jfrNebus/Safe_box/readme_español.md

# Introducción

Este proyecto nace cuando, por necesidades laborales, se necesitó una caja fuerte donde poder almacenar una serie de bienes de valor. En un momento determinado, un departamento de mi empresa retiró, por sustitución, un modelo específico de caja fuerte de un cliente. Este modelo específico tiene asociado un retardo a la apertura de la puerta; es decir, aunque dispongas de la llave y la contraseña, la activación del perno electromagnético que libera la cerradura no se producirá hasta pasado un determinado tiempo. Esto garantiza que, en caso de que el intruso intente coaccionar al responsable de la caja, esta no se abra hasta que el tiempo de retardo haya finalizado, lo que lo obliga a permanecer más tiempo en la instalación, arriesgándose a ser capturado. Esta caja fuerte fue depositada en el apartado de desechos para reciclar, era un modelo antiguo no óptimo para dicho cliente. Adicionalmente, se desconocía la contraseña.

Estas cajas están pensadas para ser fijadas a una superficie debido a que el perno actúa por gravedad. Es decir, si la bobina del perno no tiene alimentación, el perno permanece en su posición por la acción de la gravedad, bloqueando la acción de la llave sobre la cerradura. Cuando se alimenta el circuito y se introduce la contraseña de forma correcta, el circuito alimenta la bobina del perno, atrayéndolo, liberando la acción de la llave.

<br>
<br>

## Funcionamiento 🧰

<br>

<p align="center">
  
</p>

En la imagen anterior tenemos el interior del sistema de control. Lo primero que se observa es la placa de control implementada por mi; el perno electromagnético, la pieza de color amarillento en la que está escrito “12 Ohms”; y por último, el cierre y la cara interior de la cerradura. El cierre se mueve de izquierda a derecha en función de la acción de la llave. Las flechas dibujadas muestran el comportamiento del cierre y del perno en función de la alimentación que reciba la bobina. Si la bobina, la pieza rectangular amarillenta recibe alimentación, el perno, la pieza cilíndrica ubicada justo debajo de la bobina, se verá atraída hacia la bobina, permitiendo el libre movimiento del cierre. Si la bobina no recibe alimentación, el perno cae por su propio peso, bloqueando el movimiento del cierre, impidiendo la acción de la llave.

Lo primero que hice fue descubrir la forma de abrir la caja. Por suerte la llave estaba puesta en la cerradura, el problema era ver cómo sortear el perno electromagnético. Al no estar fijada a ninguna superficie, en cuanto le di la vuelta a la caja, el perno cayó por gravedad al interior de la bobina, liberando la cerradura. Una vez abierta la caja, la desmonté por completo y analicé cada parte.

<br>

### **Placa original**: 

<br>

<p align="center">
  
</p>

<br>

Esta es la placa original de la caja. Se observan un par de elementos de interés:

- Microcontrolador TSC80C31, con 32 entradas y salidas, y 128 bytes de RAM. 
- Memoria EPROM M27C64A. Esta memoria es ideal para programas largos. Como curiosidad, cabe destacar la ventana que se observa en el medio de la memoria, la cual sirve para borrar su contenido apuntando a la misma con un haz de luz ultravioleta. A continuación, se muestran unas imágenes del interior de dicha ventana al microscopio.

<br>

<p align="center">
  
  
  
 
</p>

<br>

### **Perno electromagnético**:

<br>

<p align="center">
  
</p>

<br>

Ya hemos hablado de esta parte anteriormente. Es el encargado de bloquear o liberar la acción de la llave. El valor impreso en el cuerpo es el valor de la resistencia de la bobina, en este caso 12 ohmios. Este valor es el que se toma a la hora de hacer cálculos para conocer la intensidad de corriente mínima que ha de proveer la fuente de alimentación para hacer que la bobina atraiga correctamente al perno. Cuando se alimenta la bobina por medio de los cables, se genera un campo magnético que atrae a todos los cuerpos ferromagnéticos, en este caso, el perno. Cuando la alimentación se pierde, se pierde a su vez el campo magnético, ocasionando que el perno caiga por su propio peso bloqueando el cierre.

<br>

### **Teclado**:

<br>

<p align="center">
  
</p>

<br>

A través del teclado se introduce la clave de acceso, que será recogida por la placa para su evaluación. Si la clave es correcta, el perno electromagnético se activa. 

<br>

<p align="center">
 
 
</p>

Resulta facil darse cuenta de que se trata de un teclado matricial en cuanto se observa la placa sin la capa de los números. Este teclado está compuesto por un total de 12 pulsadores de membrana conductiva. Este tipo de pulsadores están formados por dos partes: la parte de los contactos impresos en la placa, las partes ovaladas con una línea en el medio; y la capa de números, una superficie de goma con un material conductor debajo de cada botón. Cuando se presiona dicho botón de silicona, la parte conductora debajo del mismo toca los dos lados del óvalo impreso en la placa, cerrando el circuito.

<br>

<p align="center">
 
</p>

<br>

En un teclado matricial, el conexionado de los botones se realiza mediante filas y columnas; cada lado de cada botón esta conectado a una fila y a una columna. En la imagen anterior tenemos un modelo que he creado para explicar el concepto. El principio de funcionamiento se basa en alimentar uno de los lados de los pulsadores, y leer el valor de voltaje en el otro lado. Es decir, podemos alimentar con un voltaje las columnas, por ejemplo, y realizar la lectura de voltaje presente en las filas.

Supongamos que hemos pulsado el botón 4. Empezamos alimentando con voltaje solo la columna 1, dejando sin voltaje las columnas 2 y 3. La columna 1, (columns 1), se conecta con el lado 1 del botón 1, con el lado 1 del botón 2 y con el lado 1 del botón 3, (SW1, SW2 y SW3). Por lo tanto, estos tres botones pasan tener alimentación en su lado 1. Acto seguido, le indicamos al sistema que lea el valor de voltaje presente en las filas, (rows). Empieza leyendo el valor de la fila 1. En la fila 1 tenemos el lado 2 del botón 1, que no ha sido presionado, por lo tanto el circuito no se cierra y la tensión, el voltaje, enviado por la columna 1 no llega al lado 2 del botón, con lo que la lectura en la fila 1 es 0V. Esto es interpretado por el sistema como que el botón 1 no ha sido presionado. A continuación, seguimos leyendo los pulsadores de la fila 1 y nos encontramos el botón 4, que si que fué presionado. El el lado 1 del botón 4, se conecta con la columna 2, columna que no está siendo alimentada en esta fase del análisis, luego aunque se cierre el circuito al presionar el botón, la lectura en la fila 1 sigue siendo 0. Lo mismo ocurre con el botón 7. Esto quiere decir que por la fila 1 no existe voltaje alguno. En este punto se garantiza que no se ha pulsado el botón 1, porque para que dicho botón se considere pulsado, tendría que existir una lectura positiva de voltaje en la fila 1 mientras la columna 1 esta siendo alimentada.

Habiendo entendido el análisis completo del comportamiento de la fila 1 y de cada uno de los botones asociados a ella, podemos resumir el análisis de las filas 2 y 3. Continuamos leyendo el valor de voltaje en la fila 2. La columna que nos interesa es la 1, dado que el botón 2 no ha sido presionado, ocurre lo mismo que con el botón 1, no existe lectura positiva en la fila 2 cuando la columna 1 está siendo alimentada, lo que garantiza que el botón 2 no ha sido presionado. Seguimos leyendo el valor de la fila 3. El botón 3 no se presionó, no se cierra el circuito, no hay lectura de voltaje positiva en la fila 3 cuando la columna 1 está siendo alimentada, por lo que se garantiza que el botón 3 no ha sido presionado.

En este punto, habiendo recibido lectura negativa en las tres filas, el sistema entiende que el botón presionado es alguno de los asociados a las columnas 2 y 3, por lo que se repite la misma actuación. Se retira la alimentación de la columna 1, se alimenta la columna 2, y se mantiene sin alimentación la columna 3. En este punto, se inicia un nuevo proceso de lectura de filas. Empezamos leyendo el valor de la fila uno, que en este caso es un valor positivo. El valor de la fila 1 es positivo porque el botón presionado es el 4, que está asociado a la fila 1 por su lado 2, y a la columna 2 por su lado número 1. Cuando se presiona el botón 4 mientras existe alimentación en la columna 2, se cierra el circuito con la fila 1, generando un valor de lectura positivo en la fila 1. Esto es interpretado por el sistema, el valor de lectura de voltaje positivo, como que dicho botón, el botón asociado a las fila 1 y columna 2, ha sido presionado. En este momento se detiene el análisis y se realiza la operación pertinente. 

Entender el funcionamiento de un teclado matricial es vital para la optimización de recursos, cuando se trabaja con un teclado. Un teclado con 9 botones supondría, habitualmente, si no se usa un teclado matricial, el uso de 9 entradas en un microcontrolador, además de todo el cableado asociado a los mismos. Como hemos visto en el ejemplo anterior, para un teclado de 9 botones, hemos usado 6 contactos del microcontrolador. De esos 6 contactos, 3 se usan como entradas para recibir la lectura de las filas, y 3 como salidas para establecer el pulso alto de voltaje para cada columna.

<br>

<p align="center">
 
</p>

<br>

Teniendo claro qué es, y cómo funciona un teclado matricial, podemos observar, en la imagen anterior, que el teclado de la caja fuerte también es un teclado matricial. En la imagen se observan dos figuras bastante más complejas que la del primer ejemplo. Ambas figuras representan el conexionado real del teclado. En la figura de la izquierda vemos una serie de pulsadores, colocados en dos filas y orientados de forma vertical, junto a los tres diodos LED de colores. Algunas de los tramos de ciertas pistas de conexión son de color azul, representan las partes de las pistas que están impresas por la cara trasera de la placa; las pistas de color vino, representan las pistas impresas en la cara frontal de la placa. El recorrido de algunas de las pistas varía ligeramente respecto a las pistas impresas en la placa, no obstante es una representación clara. La figura de la derecha mantiene el conexionado real entre pulsadores y pines, pero he organizado todo de forma que resulte más fácil percibir la union de las columnas y las filas, con los pulsadores. Las pistas de color amarillo representan las columnas, y las pistas de color verde representan las filas. El boton * se conecta a dos pines de forma independiente, porque así lo creyó oportuno el desarrollador que diseñó la placa del circuito.
Teniendo claro todo lo explicado anteriormente, solo queda leerse las comentarios escritos en el propio código para entender el funcionamiento completo del sistema. 

<br>

<p align="center">
    
    
</p>

<br>
<br>

## Desarrollo de placa :electron:

<br>

<p align="center"> 
  
  
</p>

El proyecto se encuentra actualmente en la versión dos. Al igual que se han modificado varios bloques de código para corregir ciertas prácticas de programación, y para incorporar nuevos elementos de electrónica, se ha corregido y rediseñado la propia placa. En las anteriores fotos se pueden observar ambas caras de la placa correspondiente a la versión uno.

<br>

En un origen usé un mosfet IRFP150 para el control del perno electromagnético, porque era lo que tenía más a mano en mi taller, no obstante este mosfet esta sobredimensionado para este circuito. Recientemente, a la hora de rediseñar la placa, encontré un transistor TIP31 en el taller, el cual es más acorde a las necesidades del circuito. Donde el mosfet aguanta valores en drain-source de hasta 100V de tensión y 44A de corriente, el tip31 aguanta en colector-emisor de hasta 40V de tensión y 3A de corriente.

En la versión uno del circuito, la gestión de los led se lograba por medio de un tipo de lógica de programación erronea; actualmente esa lógica se ha corregido y se han implementado 3 transistores para el control de los led. El transistor usado es el 2N3904, cuyos valores máximos en colector-emisor son 40V y 200mA, valores de sobra para controlar leds que trabajan en torno a los 2V y 20 miliamperios.

<br>

### **Cálculo de resistencias :zap:** 

<br>

A continuación, se muestran todas las operaciones necesarias para el cálculo de resistencias en base de los transistores de la placa.

<hr>
RBE = Resistencia base-emisor.
<br>
VB = Tensión en base.
<br>
IB = Corriente en base.
<br>
β = Ganancia de intensidad para el transistor, (also known as hFE).
<br>
IC = Corriente en colector.

<br>
<br>

RBE = VB / IB
<br>
β = IC / IB  >> IB = IC / β
<br>
0.7 = Caida de tensión en la únion base-emisor del transistor.

<br>
<br>

•	Sin aplicar el factor de protección sobre Ib:

  RBE = (VB - 0.7) / (IC / β)

<br>
<br>

•	Con factor de protección sobre Ib:

  RBE = (VB - 0.7) / 3 * (IC / β)
  
  Este factor se usa para incrementar la intensidad en base, esto garantiza que el transistor entre en saturación profunda y funcione como un interruptor.

<hr>

<br>

#### - Resistencia base-emisor TIP31

<br>

β mínima según datasheet = 25
<br>
β según polímetro = 25

•	Sin aplicar el factor de protección sobre Ib:
RBE = (5 – 0.7) / (1 / 25) = 107,51

•	Con factor de protección sobre Ib:
RBE = (5 – 0.7) / 3 * (1 / 25) = 35,8

Al final se usa el cálculo con factor de protección para garantizar la saturación del transistor en su uso como interruptor. Se usa un valor de resistencia común de 22Ω.

<br>

#### - Resistencia base-emisor 2N3904 y resistencias de protección para los led.

<br>

**Resistencias de protección para los LEDs**

Se trata de 3 led de 3mm.
<br>
•	Rojo: 20mA, 1.9-2.1V.
<br>
•	Amarillo: 20mA, 2V.
<br>
•	Verde: 20mA, 2.2-2.4V

Calculo de la resistencia en serie para proteger el led:

R = (Vfuente – VLED) / I

•	Rojo y amarillo:
<br>
R = (12 – 1.9) / 0.02 = 505 Ohms
<br>
•	Verde:
<br>
R = (12 – 2.2) / 0.02 = 490 Ohms

Finalmente, se usan resistencias de 560Ω. Esto es debido a que el otro valor estándar inmediato es de 470Ω. Es preferible exceder el valor, antes que quedarse corto y forzar los leds. No obstante, el daño ocasionado por una resistencia de 470Ω sería prácticamente nulo.

<br>

**Resistencias base-emisor**

β según data sheet = 100
<br>
β según multímetro = 151

•	β según data sheet: 
  RBE = (5-0.7) / (3*(0.02/100)) = 4,3 / (3 * 0.0002) = 4,3 / 0.0006  = 7166,66

Se usa un valor de resistencia común de 5,6kΩ.

<br>

### **Desarrollo del PCB :mechanic:**

A continuación se muestra el esquema eléctrico, el diseño de la PCB, y el modelo 3D de la misma.

<br>
<br>

<p align="center"> 
 
</p>

<br>

Haciendo clic en el siguiente [enlace](Docs/Images/V1_schematic.png), podemos acceder al esquema electrónico de la primera versión de la placa. En un origen se escribió el código estableciendo el conexionado entre los pines del teclado y los pines del aruino, siguiendo la correlación numérica, es decir, el pin 1 del conector del teclado con el pin 1 de la placa etc. Esto generaba que, por la ubicación del conector del teclado y la posición del arduino, el cableado entre pines se cruzase. Esto ha sido corregido en código, generando un conexionado mucho más limpio. Adicionalmente, el esquema de la versión 2 incluye el bloque de conexiones de los transistores de control para el manejo de los led.

Para este proyecto tuve que crear un nuevo elemento, el conector hembra de 13 pines. O bien no lo encontré entre las librerías pero existe, o bien no existe. Para su creación tomé como referencia uno de menor número de pines.

<br>

<p align="center"> 
 
 
</p>

<br>

De izquierda a derecha: capa superior, ubicación de los elementos; capa inferior, routeo de los elementos; capa de drill, mapa de perforación de los pad de los elementos.

<br>

<p align="center"> 
 
 &nbsp;
 
 &nbsp;
 
</p>

<br>

De izquierda a derecha: capa superior, capa mixta, capa inferior.

<p align="center"> 
 
 &nbsp;
 
 &nbsp;
 
</p>

**Nota:** El diseño 3D del arduino seleccionado presenta un error, se observa un integrado atravesando el arduino. 

Algunos de los elementos seleccionados no tienen archivo 3D. En este proyecto no se ha prestado atención al elemento concreto seleccionado en la librería. La placa se solicitó sin los elementos incluidos ya que se iban a usar elementos própios.

<br>

### **Resultado final :magic_wand:**

Se envió a producir la placa el día 24 de noviembre de 2024 y se recibió el 4 de diciembre. Se realizó el pedido mínimo de 5 placas, sin incluir los componentes, por un valor de 4.29€. El método de envío solicitado fue el más económico, "Global Standard Direct Line", cuyo tiempo de entrega oscila entre los 12 a 16 días. El importe del envío fueron 1.69€. Adicionalmente, se añadió un pago por valor de 1.25€ en concepto de de impuestos y aduanas, y 50 céntimos más por usar paypal como forma de pago. En total, se pagó 7.73€ por 5 placas sin componentes.

<br>

<p align="center"> 
 
 &nbsp;
 
 &nbsp;
 
</p>

Como es habitual, el resultado obtenido es impecable. No se encuentra fallo alguno de fabricación en la placa. No obstante, si que se han cometido errores en el diseño de la misma. 
* No se agregó la polaridad de cada entrada de las clemas, en la capa de serigrafía. Esto puede conducir a problemas cuando se alimenta la placa, o cuando se alimenta el perno electromagnético (el perno tiene un diodo de protección entre contactos, si se conecta de forma erronea se pueden producir daños en el transistor TIP31).
* Los agujeros de fijación de la parte inferior de la placa, no se encuentran ubicados correctamente. Se cometió un error a la hora de establecer las medidas tomadas con un calibre, durante el diseño del PCB.
* Se diseñó y programó la parte de control de los led, siguiendo un análisis incorrecto del teclado. En el esquema de la versión 1 de la placa, [V1_schematic](Docs/Images/V1_schematic.png), se mostra la unión del cátodo del led verde con el pin 10 del conector, y el cátodo del led rojo con el pin 12. Esto es erroneo, dado que ocurre justamente al revés. Durante el proceso de prueba de la nueva placa, se observó que el led rojo realizaba las acciones asociadas al led verde, y al contrario. Para corregir este problema, se reasignaron las salidas analógicas A2 y A4, que originalmente estaban asociadas al led rojo y al led verde respectivamente. De esta forma, el led rojo pasa a estar asociado a la salida A4 y el verde a la salida A2. Adicionalmente, se han modificado los nombres de los transistores de control de cada led; y los nombres de las redes asociadas a las uniones de ambos pines del conector, es decir, los pines 10 y 12, con las resistencias de protección R5 y R7, respectivamente, dentro del esquema eléctrico.
Algunos componentes no han quedado bien soldados. La clema de alimentación en la parte superior izquierda de la placa, o el TIP31, han quedado ligeramente ladeados. Además, aunque en general las soldaduras tienen buena forma, están sucias, queda limpiarlas con alcohol isopropílico.

<br>

## **Conclusión :thinking:**

La versión 2 de la placa ha supuesto una mejora considerable con respecto a la versión 1. Se han corregido múltiples fallos de código y se ha mejorado notablemente la parte de hardware. Además, el resultado profesional obtenido gracias a producir el pcb con una empresa profesional, ha sustituido a la producción del pcb con placas perforadas breadboard de soldar.
Pese a estos cambios, la versión 2 se puede mejorar. En un futuro, la versión 3 corregirá los errores de diseño citados anteriormente. Además, actualmente estoy esperando a que me lleguen unos microcontroladores que he pedido, con la intención de intentar sustituir el arduino. De esta forma, la versión 3 sería más compacta.
