jfrNebus/Safe_box/Docs/Correlación de pulsadores con pines.txt

Pulsador  |  Pines
   1      =   1 5
   2      =   2 5
   3      =   3 5
   4      =   1 6
   5      =   2 6
   6      =   3 6
   7      =   1 7
   8      =   2 7
   9      =   3 7
   0      =   2 8
   #      =   3 8 
   *      =   4 9
  rojo    =   10
 amarillo =   11
  verde   =   12
   +      =   13

pin 1 = 1 7 4
pin 2 = 2 5 8 0
pin 3 = 3 6 9 #
pin 4 = *
pin 5 = 1 2 3
pin 6 = 4 5 6
pin 7 = 7 8 9
pin 8 = 0 #
pin 9 = *
