jfrNebus/Safe_box/Docs/Circuit_emulation/Emulation_software_link.txt

Link al software de simulación online.

https://masterplc.com/simulador/
