jfrNebus/Safe_box/Docs/Circuit_emulation/Saved_schematic/V1_emulation.jpg

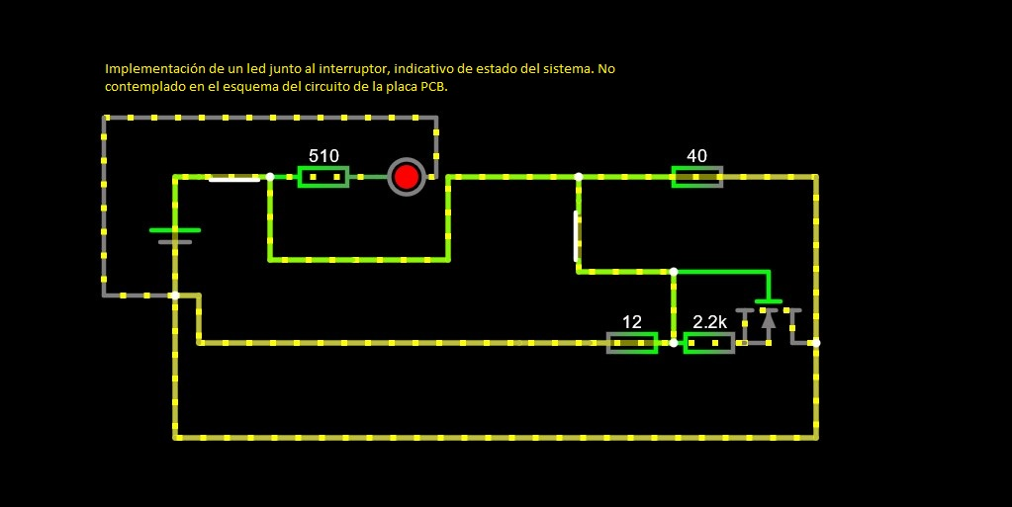
Docs/Circuit_emulation/Saved_schematic/V1_emulation.jpg
