jfrNebus/Safe_box/Docs/Images/Microscope_images/5.jpg

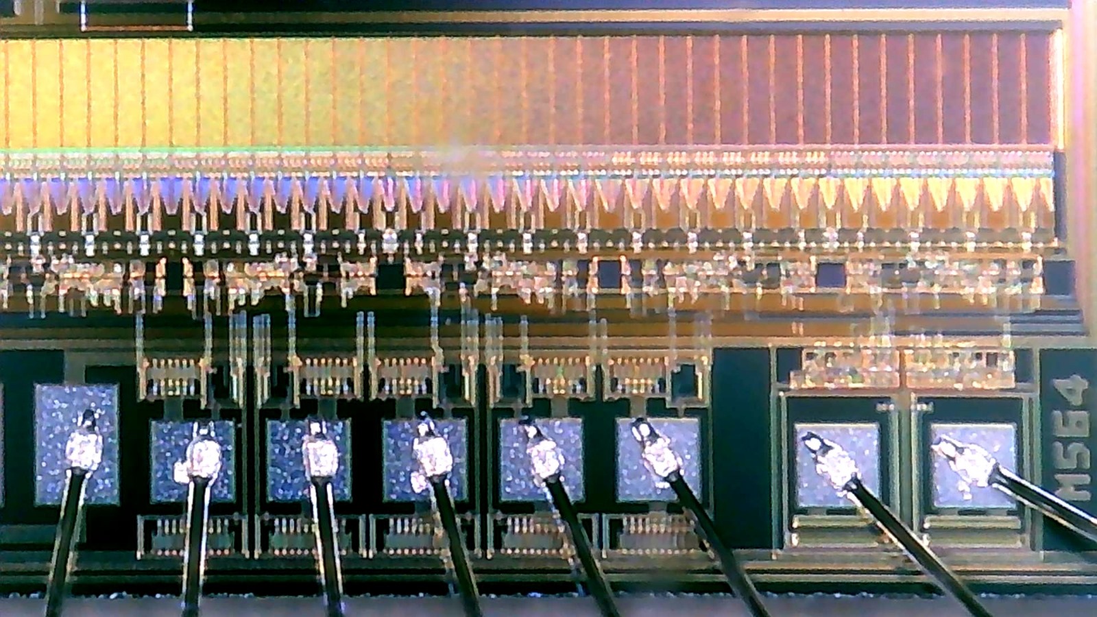
Docs/Images/Microscope_images/5.jpg
