jfrNebus/Safe_box/Docs/Images/V1_schematic.png

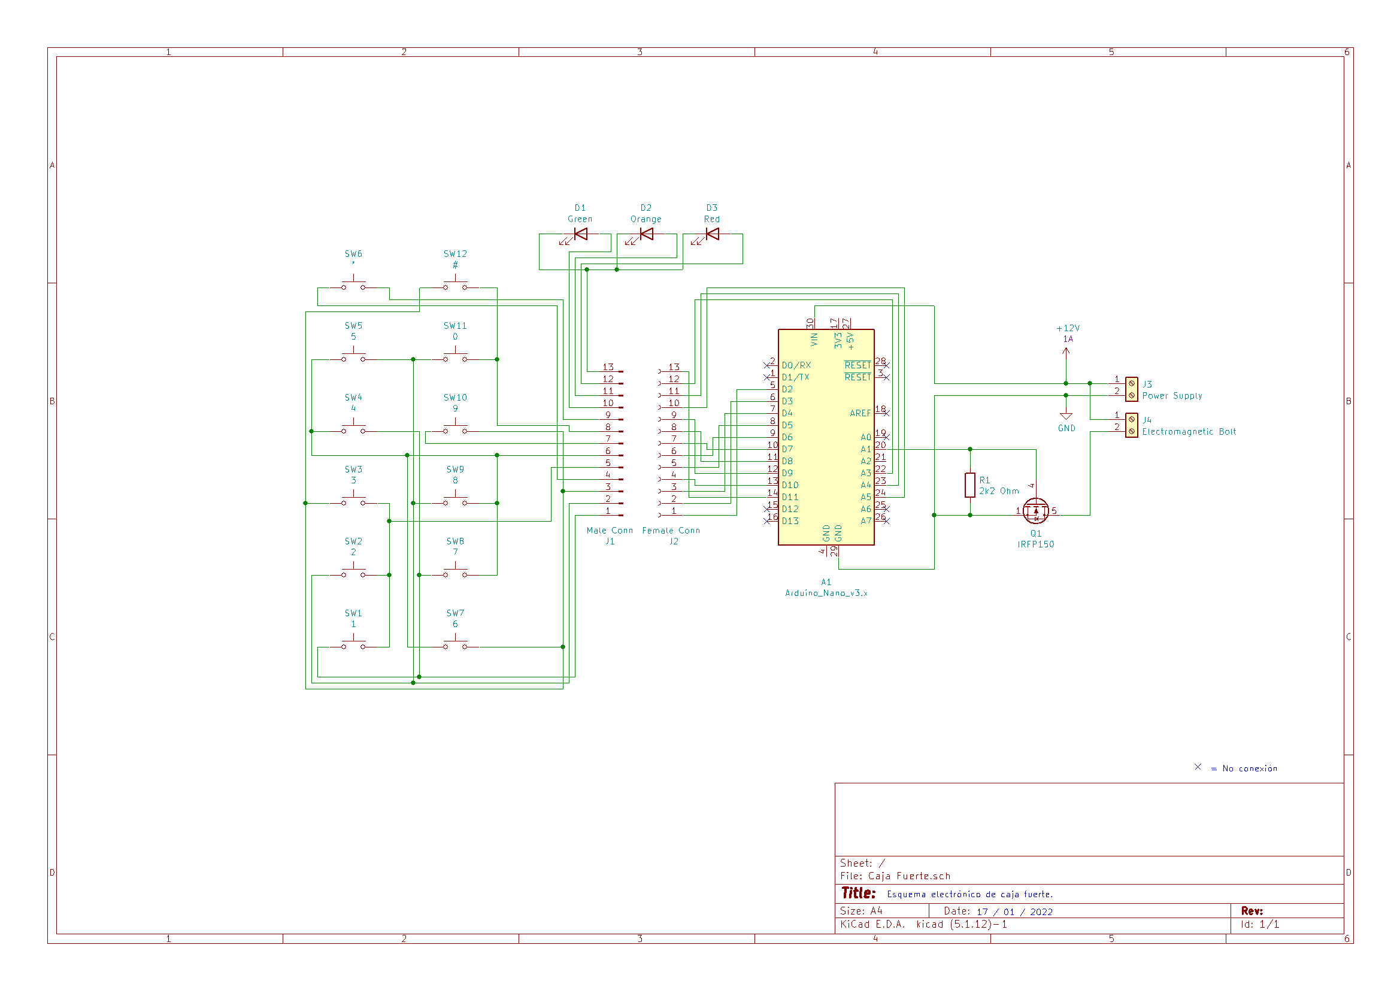
Docs/Images/V1_schematic.png
