jfrNebus/Safe_box/Docs/Schematics/actual_keyboard_layout.pdf

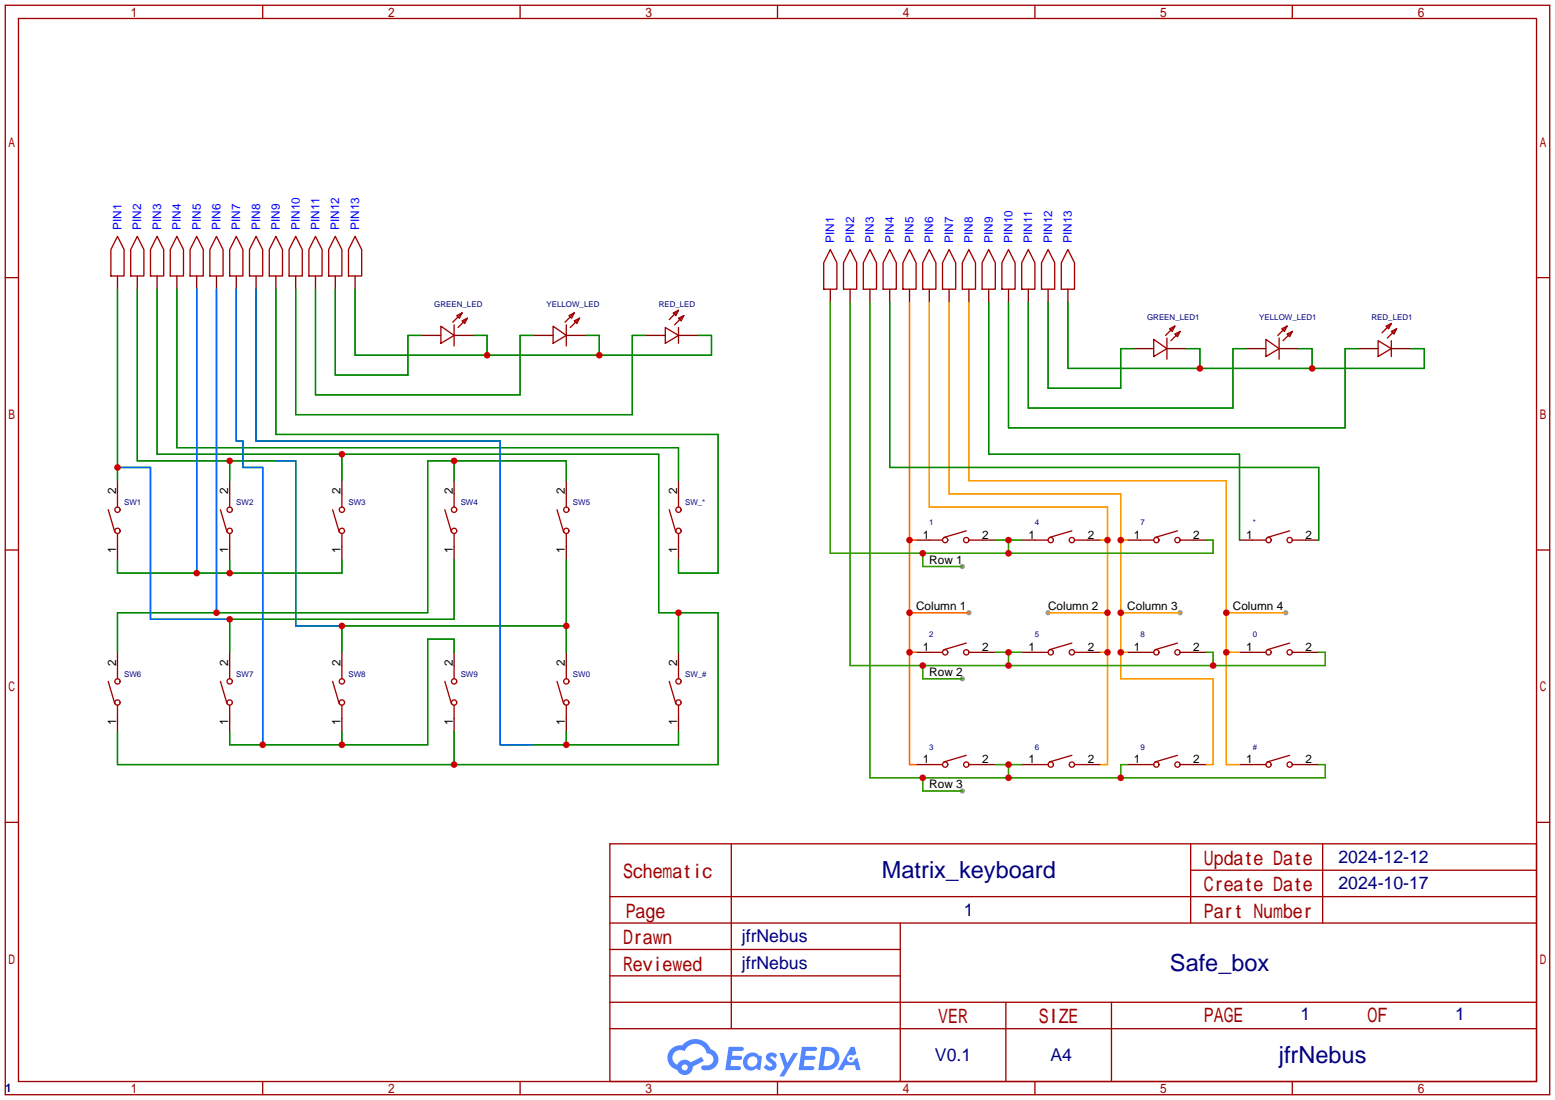
[picture p25: page 1]
