jfrNebus/Safe_box/Docs/Schematics/board_schematic.pdf

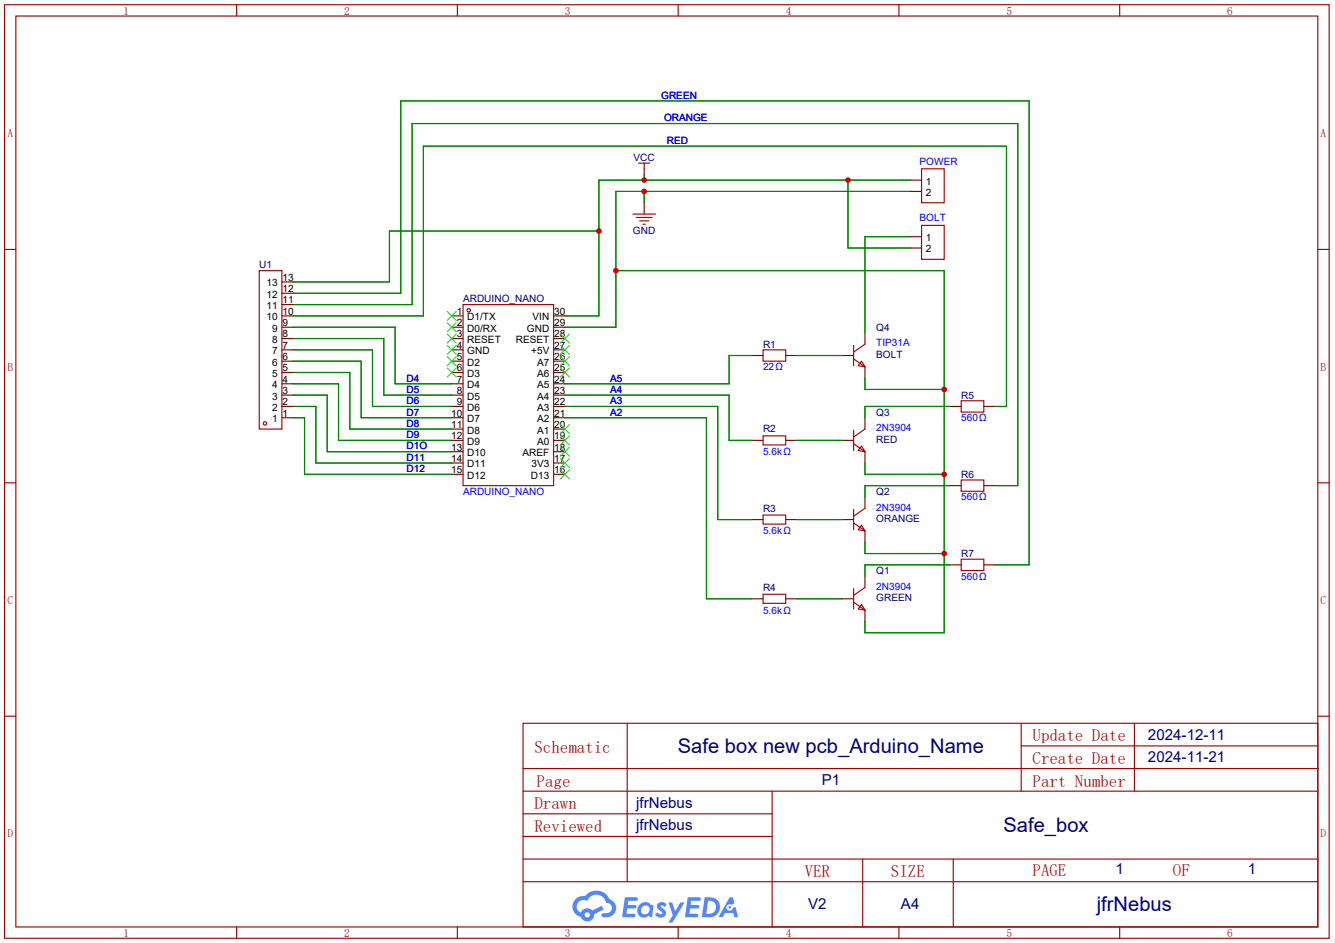
[picture p26: page 1]
