jfrNebus/Safe_box/Docs/Schematics/pcb_design.pdf

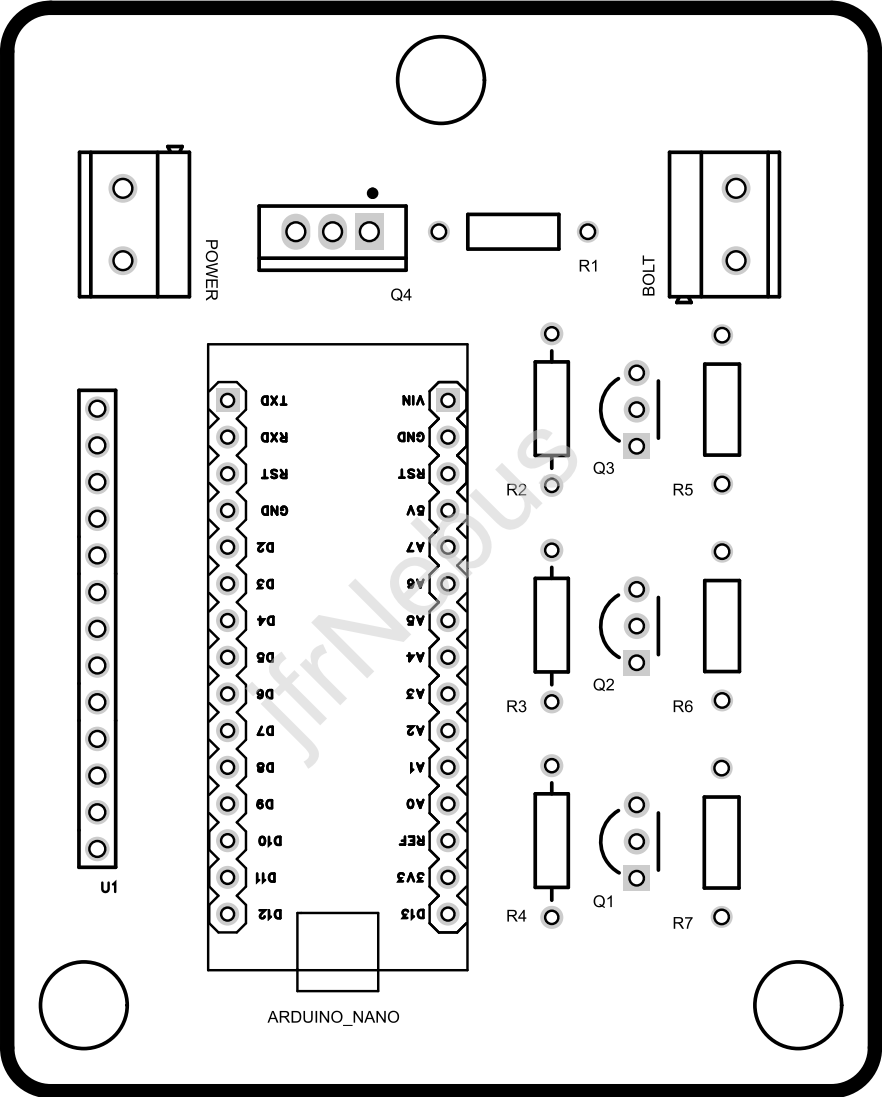
[picture p27: page 1]

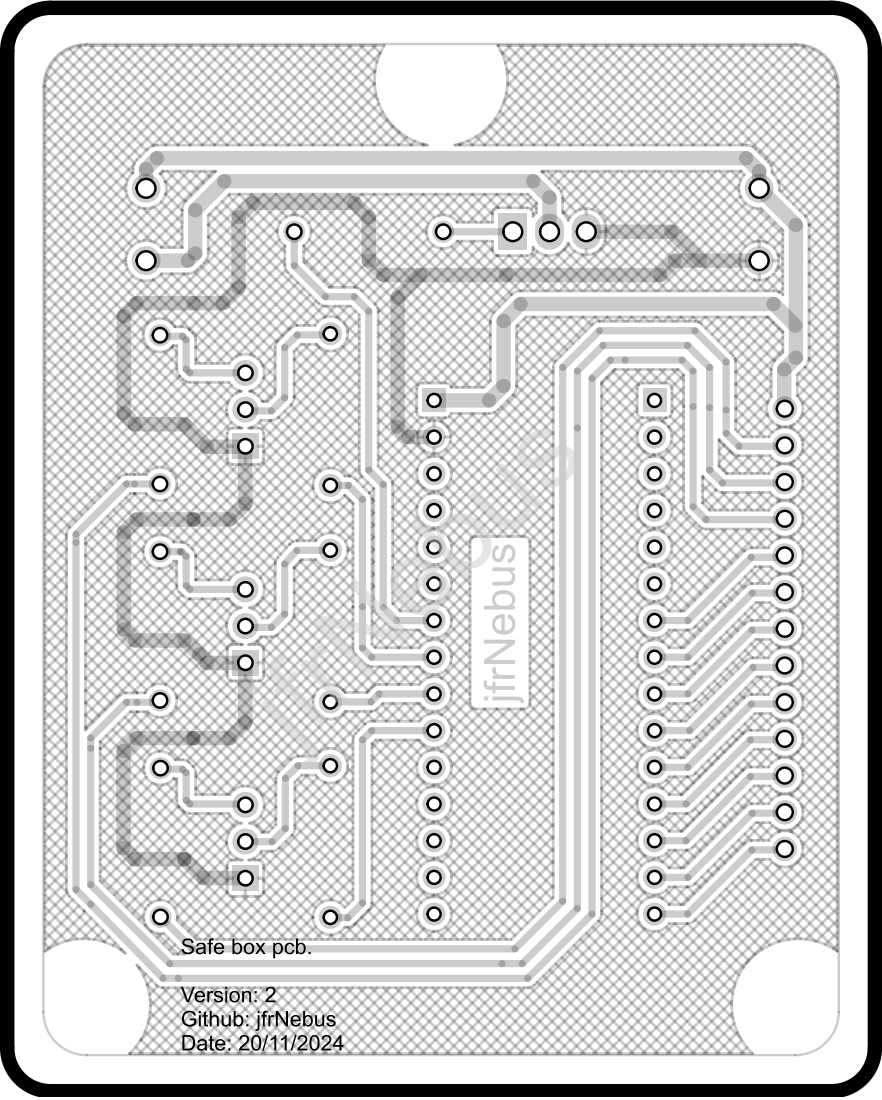
[picture p28: page 2]

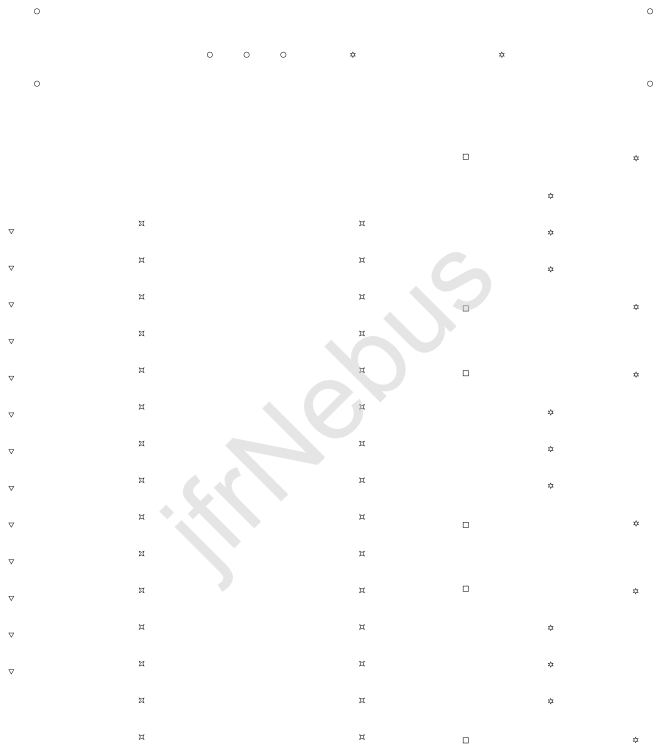
[picture p29: page 3]
