jfrNebus/Safe_box/Docs/Logic_tree.pdf

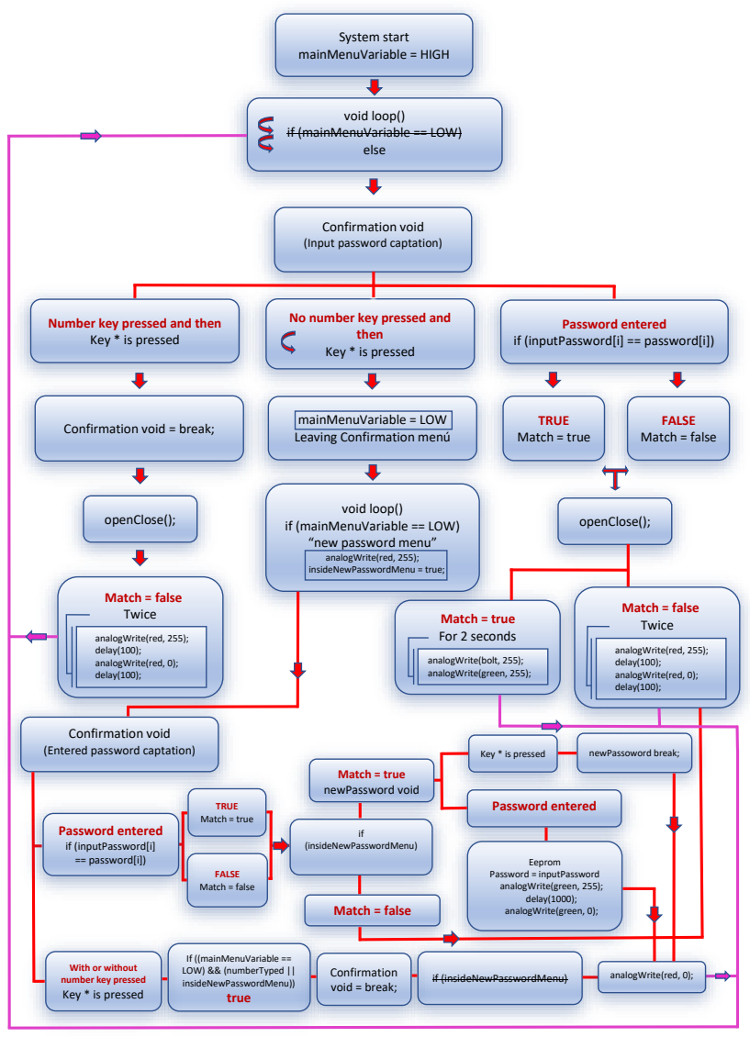
[picture p30: page 1]
System start mainMenuVariable = HIGH; void loop(); else; TRUE Match = true; Password entered; FALSE Match = false; openClose();; Match = true For 2 seconds; analogWrite(bolt, 255); analogWrite(green, 255);; Match = false Twice; analogWrite(red, 255); delay(100); analogWrite(red, 0); delay(100);; If ((mainMenuVariable == LOW) && (numberTyped || insideNewPasswordMenu)) true; if (insideNewPasswordMenu); Match = true newPassword void; Match = false; newPassoword break;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

if (mainMenuVariable == LOW)

Confirmation void
(Input password captation)

No number key pressed and

Number key pressed and then

Key * is pressed

then

if (inputPassword[i] == password[i])

mainMenuVariable = LOW
Leaving Confirmation menú

Confirmation void = break;

“new password menu”
analogWrite(red, 255);
insideNewPasswordMenu = true;

(Entered password captation)

With or without
number key pressed

if (insideNewPasswordMenu) Confirmation
void = break;
