jfrNebus/Safe_box/Keyboard_english_V2/Teclado/Teclado.ino

#include <EEPROM.h>

//----------- Matrix push buttons
int pin1 = 12;
int pin2 = 11;
int pin3 = 10;
int pin4 = 9;  //<<< No matrix push button, button *
int pin5 = 8;
int pin6 = 7;
int pin7 = 6;
int pin8 = 5;
int pin9 = 4;  //<<< No matrix push button, button *
//----------- Electromagnetic bolt
int bolt = A5;
//-----------
//Leds. Each one of these pins are connected to a transistor on its base, to control each
//LED individually.
int red = A4;
int orange = A3;
int green = A2;
//-----------
int keyColumn;                                       //Bound for first dimension in multidimensional array.
int keyRow;                                          //Bound for second dimension in multidimensional array.
boolean keyDetected = false;                         //Boolean that we will use to know if we pressed any key.
boolean insideNewPasswordMenu = false;               /*This boolean will allow us to know in which part of the code we
as well as to be able to make * button multipurpose. This is because * button will behave in different
if insideNewPasswordMenu is true or false.
*/
byte password[] = { 1, 1, 1, 2, 2, 2 };              /*The default password, and the password array that will be
overridden once we save the new password in the Eeprom memory.
*/
byte numberOfDigits = 6;                             /*Number of digits of our password. This variable will set the amount of
iterations for each for loop action. This is reading, printing or burning the password from / in Eeprom's memory.
*/
const byte C = 4;                                    //Columns
const byte R = 3;                                    //rows
bool match = false;                                  /*Boolean that will allow to control different contionals in the code based
on whether the entered password was correct or not.
*/
//Columns and rows store the pins according to the electronics schematic.
int columns[C] = { pin5, pin6, pin7, pin8 };
int rows[R] = { pin1, pin2, pin3 };
int result[C][R];            /*In "result" multy dimensional array, we will use the number of columns and the number of rows
as its dimensions. Later, we will give a value to each one of the combination, and this will be the 0-9 and *
representation. Short explanation: if pin 5 of columns gets connected with pin 2 of rows, we will
get the value "2", so the conexion of pin5 and pin2 is equal to key 2 in the keyboard.
*/
int mainMenuVariable = HIGH; /*This variable is where we will store the reading of * button, default
value is high. * button is multipurpose, it will help us to either leave password menu without making
any change, to cancel a wrong input, etc. This conditions will be met once mainMenuVariable == LOW.
*/
void setup() {
  //----------- Pin setup for * button.
  /*
  The button * is not conected to the push button matrix. We set one of its pins to an output pin
  in the arduino board set as LOW. The other one is connected to an input pin set as HIGH. When we send a
  LOW state through the pin number 4, and this signal is read in the pin number 9, which is HIGH by default, 
  the value read will be LOW. There's a deeper explanation about this subject in the void pinSetUp.
  */
  pinMode(pin4, OUTPUT);
  digitalWrite(pin4, LOW);
  pinMode(pin9, INPUT_PULLUP);
  //----------- Pin setup for all the transistors.
  pinMode(bolt, OUTPUT);
  pinMode(green, OUTPUT);
  pinMode(orange, OUTPUT);
  pinMode(red, OUTPUT);
  //-----------
  Serial.begin(9600);
  /*Now we set the values for each pin combination. According to the keyboard connexions schematic, 
  the conexion between pin1 and pin5 belongs to button number 1. Since columns array's members are: 
  pin5, pin6, pin7 and pin8; and since rows array's members are: pin1, pin2, and pin3; the conexion 
  between pin5 and pin1, is equal to the vaule stored in result[poisition of pin5 in columns = 0]
  [position of pin 1 in rows = 0] => result[0][0] = 1. Same way, according to schematic, button 2 is
  equal to pin5 and pin2, so same way we have that result[first member in columns array = 0][second
  member in rows array = 1] = result[0][1] = 2. And so on. result[3][2] = pin8 and pin3 is equal to # 
  button, but, since we are working with int arrays, we represent it with number 11. We are not using
  # key at all tho.
  */
  result[0][0] = 1;
  result[0][1] = 2;
  result[0][2] = 3;
  result[1][0] = 4;
  result[1][1] = 5;
  result[1][2] = 6;
  result[2][0] = 7;
  result[2][1] = 8;
  result[2][2] = 9;
  result[3][1] = 0;
  result[3][2] = 11;
  pinSetUp(columns, rows);  //We call pinSetUp void, the one that will set up all pins. Check pinStUp void for
  //deeper explanations.
  checkEepromState(numberOfDigits); 
  /*The Eeprom memory must be checked to be able to update password[] with the right values. According to the 
  eeprom values, this method will perform different acctions.
  */
  startingLights();                       //We load starting lights sequence.
}
void loop() {
  /*Main loop of the system is based on mainMenuVariable. This variable is the one that sets us "inside password change"
  menu or not. If this variable is equals to low, then we get in the menu to change password, otherwise we will just
  load the confirmation void, and then the openClose void. Confirmation menu will check if what we typed is equal to
  actual value of Eeprom memory. If both passwords are equals, it will set match = true. openClose, according to the value 
  of "match" variable set by "confirmation" void, will send a high pulse through A1 to the gate of mosfet and will trigger
  a green led for 2 seconds; or red LED will blink twice if the password typed was wrong.
  In the other hand we have the new password menu. If mainMenuVariable == LOW, we get in this menu. This means that
  confirmation menu was loaded at least once, and it detected that * key was pressed. Since * was pressed, mainMenuVariable
  changed from HIGH to LOW. Once inside this conditional, we will start by turning on the red LED constantly till we leave
  this menu. This is meant to help the user to know which part of the code is being executed all the time. Then we send
  a message to serial monitor and we set insideNewPasswordMenu as true. Orange led blinks 2, visual purpose only.
  In order to reach the "newPassword" void, a right password must be registered by "confirmation". Confirmation void will 
  set match to true or false. After loading confirmation void, and if insideNewPasswordMenu is still true, (it can change during
  confirmation void), we load newPassword void. Once this void is over, we turn off red LED, and we leave new password menu.
  */
  Serial.println("Main Menu.");
  if (mainMenuVariable == LOW) {
    analogWrite(red, 255);
    Serial.println("Inside new password conditional.");
    insideNewPasswordMenu = true;
    analogWrite(orange, 255);
    delay(100);
    analogWrite(orange, 0);
    delay(100);
    analogWrite(orange, 255);
    delay(100);
    analogWrite(orange, 0);
    confirmation(password, numberOfDigits, columns, rows);
    if (insideNewPasswordMenu)
      newPassword(password, numberOfDigits, columns, rows);
    analogWrite(red, 0);
  } else {
    confirmation(password, numberOfDigits, columns, rows);
    openClose();
  }
}
