jfrNebus/Safe_box/(commit log)

2024-10-14 First safe box project commit
    [Caja Fuerte.kicad_pcb, Caja Fuerte.sch]
2024-10-14 Name change and directories management
    [Caja Fuerte.kicad_pcb, Caja Fuerte.sch]
2024-10-15 More file and directory management
    [Caja Fuerte.kicad_pcb, Caja Fuerte.sch]
2024-10-15 Uploading board pics
2024-10-16 Uploading bolt_work image
2024-10-16 Uploading detailed image of electromagnetic bolt
2024-11-07 Adding few mosfet / transistor alternatives
2024-11-09 Updating few docs related with arduino nano pin out, and transistor resistances
2024-11-20 Updating Keyboard_V2: adding a system to burn in the eeprom memory the default password, in case the password[] and the password stored in the eeprom memory don't match.
    [Teclado.ino, Voids.ino]
2024-11-21 Implementing a system to overwrite new arduino memory slots.
2024-11-25 Updating 3D pcb views pics.
2024-12-11 Updated board_chematic jpg and pdf files.
2024-12-11 Updated V1_schematic name, and uploaded pictures about the final pcb result
